codeThatThinks/autotank/Readme.md

# Autotank

A robotic tank designed to carry heavy objects both indoors and outdoors. Currently RC control, but will eventually be autonomous with bluetooth-enabled "follow me" capability.
