codeThatThinks/autotank/Solidworks/autotank.SLDASM

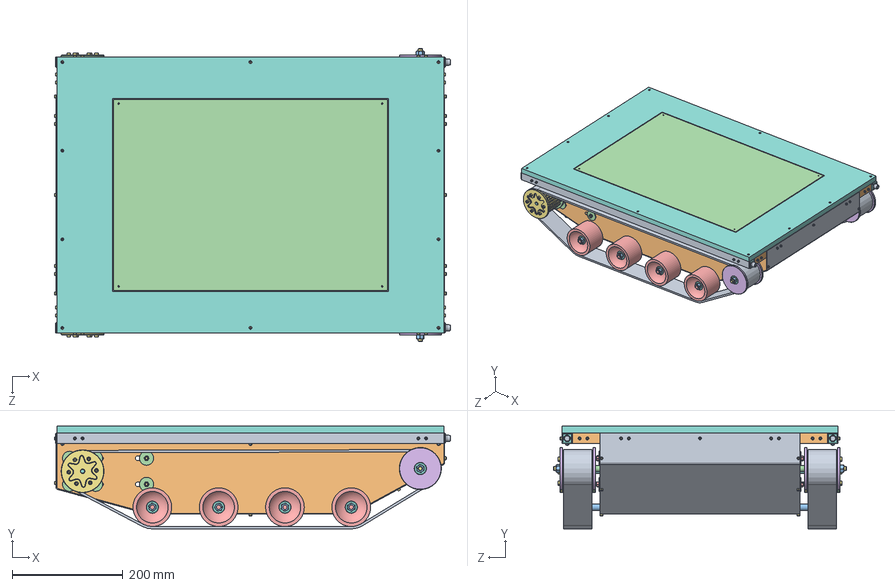
[picture p1: CAD file, 2020-02-22]
Solidworks/autotank.SLDASM
716.7 x 186.0 x 530.0 mm
chassis_bottom_plate
chassis_side_plate x 2
chassis_road_wheel_spacer x 8
chassis_idler_pulley_spacer x 2
chassis_road_wheel_axle x 4
chassis_road_wheel_support x 4
socket head cap screw_am x 80
deck_top
deck_tube_side x 2
deck_tube_ends x 2
deck_tube_inside x 2
deck_top_hatch
deck_tube_inside_support
deck_corner_bracket x 12
deck_tube_cap x 2
deck_tube_cap_front x 2
headlight x 2
socket countersunk head screw_am x 34
hex nut style 1_am x 65
self-clinching nut_pmm x 4
track_road_wheel x 8
track_idler_pulley x 2
track_drive_pulley x 2
bearing_608 x 22
track_belt^track x 2
track_idler_pulley_spacer x 2
track_shaft_collar x 2
track_drive_pulley_end_cap x 2
track_drive_pulley_threaded_insert x 12
motor_turnigy_d5035_125kv x 2
motor_adapter_nema23_44mm_countersunk x 2
shaft_8mm_keyed^motor x 2
motor_mounting_plate x 2
motor_tensioner_plate x 2
motor_tensioner_ball_bearing^motor x 2
flat washer type b wide_ai x 12
nut_m5_din934 x 12
motor_slot_spacer x 8
belt_tensioner_plate x 4
belt_tensioner_nut^belt_tensioner x 2
