codeThatThinks/autotank/Solidworks/belt_tensioner/belt_tensioner.SLDASM

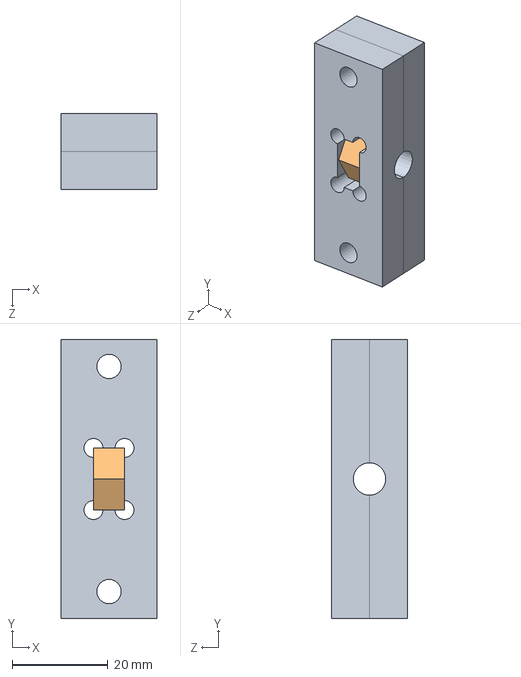
[picture p2: CAD file, 2020-02-22]
Solidworks/belt_tensioner/belt_tensioner.SLDASM
20.0 x 58.4 x 15.9 mm
belt_tensioner_plate x 2
belt_tensioner_nut^belt_tensioner
