codeThatThinks/autotank/Solidworks/deck/deck.SLDASM

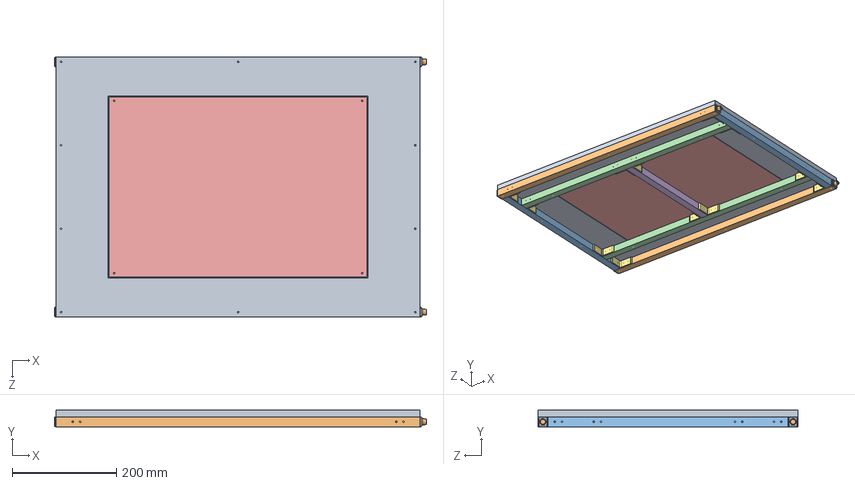
[picture p3: CAD file, 2020-02-22]
Solidworks/deck/deck.SLDASM
715.1 x 31.8 x 500.0 mm
deck_top
deck_tube_side x 2
deck_tube_ends x 2
deck_tube_inside x 2
deck_top_hatch
deck_tube_inside_support
deck_corner_bracket x 12
deck_tube_cap x 2
deck_tube_cap_front x 2
headlight x 2
