codeThatThinks/autotank/Solidworks/motor/motor.SLDASM

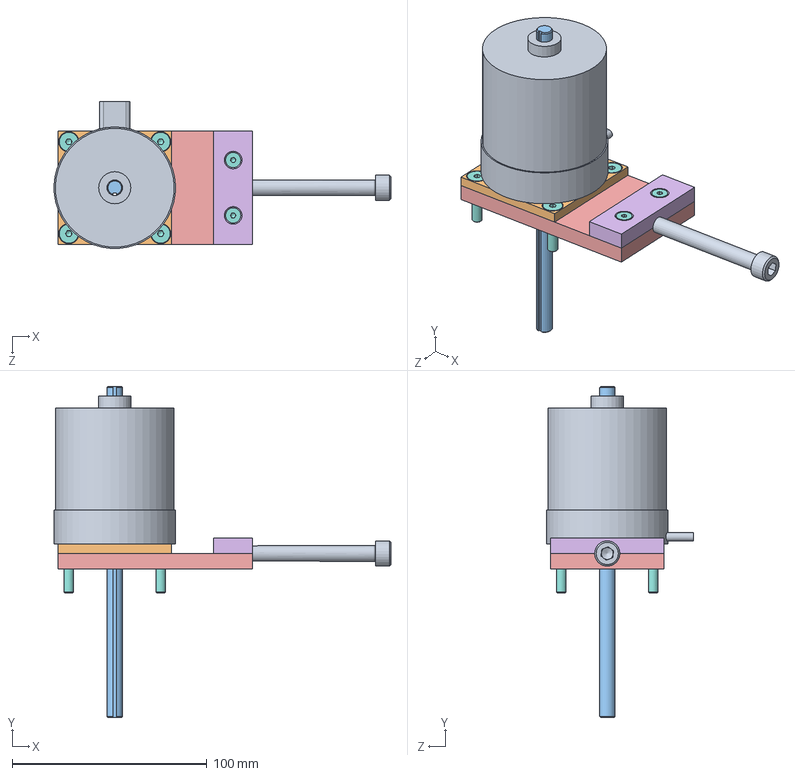
[picture p4: CAD file, 2020-02-22]
Solidworks/motor/motor.SLDASM
173.0 x 170.0 x 75.3 mm
motor_turnigy_d5035_125kv
motor_adapter_nema23_44mm_countersunk
shaft_8mm_keyed^motor
bearing_608
motor_mounting_plate
motor_tensioner_plate
motor_tensioner_ball_bearing^motor
socket countersunk head screw_am x 10
socket head cap screw_am
