codeThatThinks/autotank/Solidworks/track/track.SLDASM

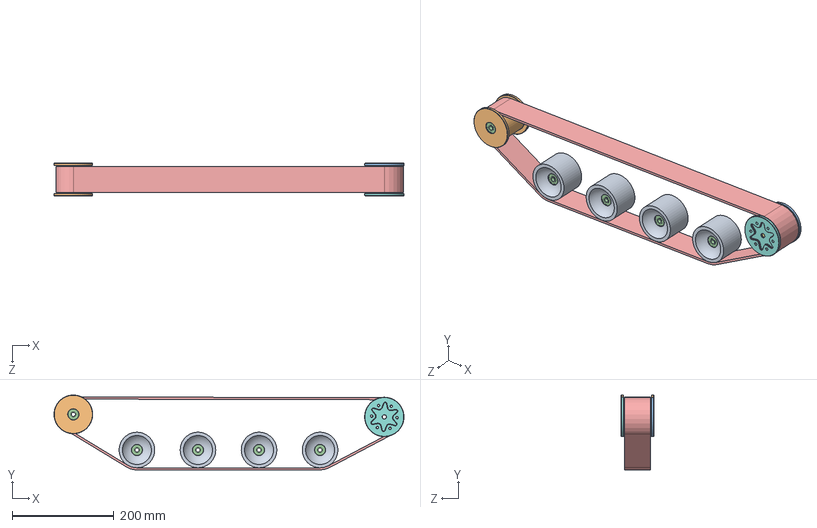
[picture p5: CAD file, 2020-02-22]
Solidworks/track/track.SLDASM
687.9 x 147.2 x 64.8 mm
track_road_wheel x 4
track_idler_pulley
track_drive_pulley
bearing_608 x 10
track_belt^track
track_idler_pulley_spacer
track_shaft_collar
track_drive_pulley_end_cap
