codeThatThinks/autotank/Solidworks/chassis/chassis.SLDASM

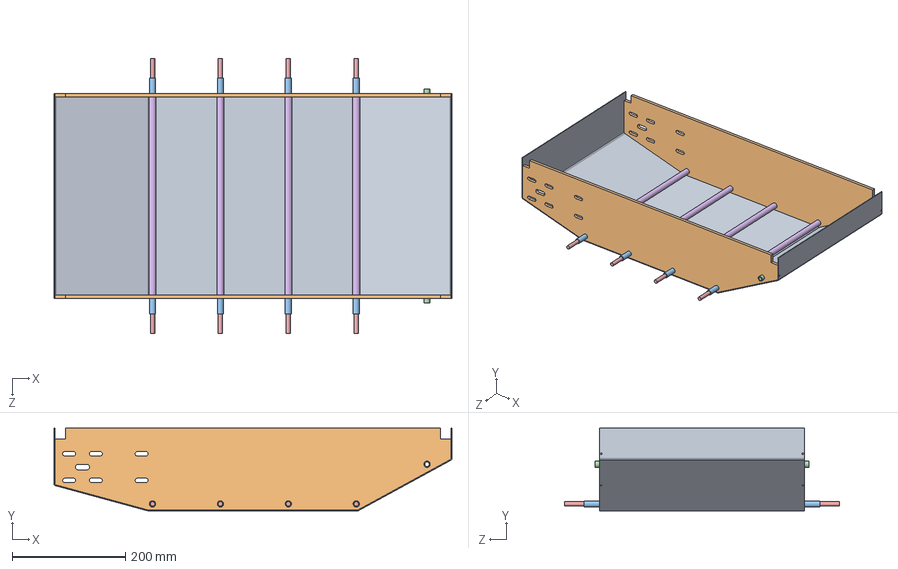
[picture p6: CAD file, 2020-02-22]
Solidworks/chassis/chassis.SLDASM
703.2 x 146.6 x 485.0 mm
chassis_bottom_plate
chassis_side_plate x 2
chassis_road_wheel_spacer x 8
chassis_idler_pulley_spacer x 2
chassis_road_wheel_axle x 4
chassis_road_wheel_support x 4
