codeThatThinks/autotank/Solidworks/track/track_right.SLDASM

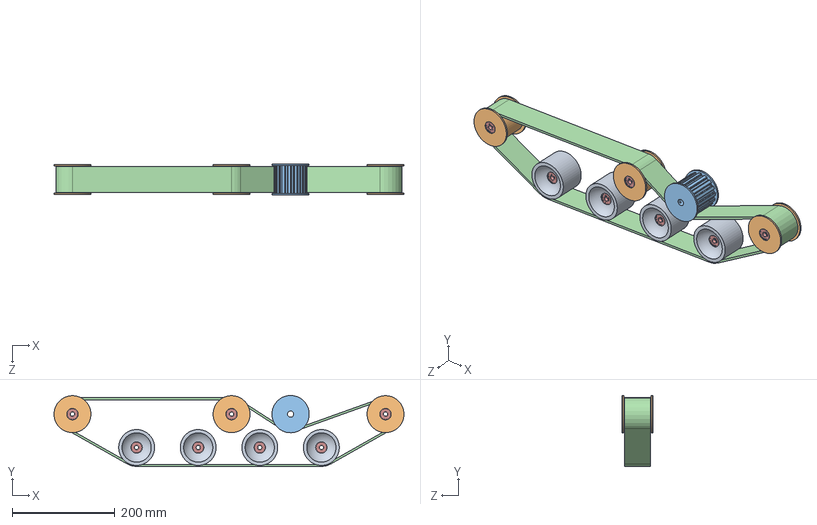
[picture p7: CAD file, 2019-06-30]
Solidworks/track/track_right.SLDASM
682.0 x 138.4 x 60.8 mm
track_road_wheel x 4
track_idler_pulley x 3
track_drive_pulley
track_belt^track_right
bearing_608 x 14
