codeThatThinks/autotank/Solidworks/track/track_left.SLDASM

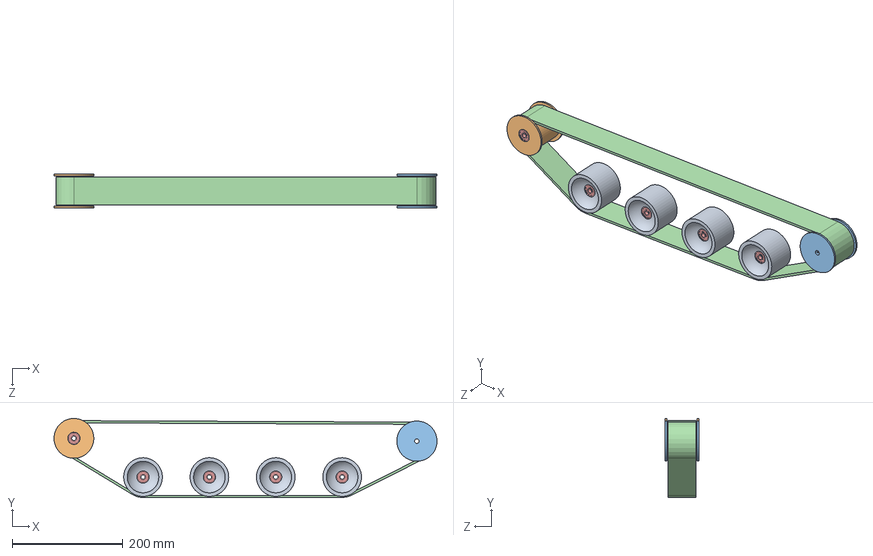
[picture p8: CAD file, 2019-06-30]
Solidworks/track/track_left.SLDASM
692.5 x 143.0 x 60.8 mm
track_road_wheel x 4
track_idler_pulley
track_drive_pulley
track_belt^track_left
bearing_608 x 10
