codeThatThinks/autotank/Solidworks/chassis/chassis_bottom_plate.sldprt

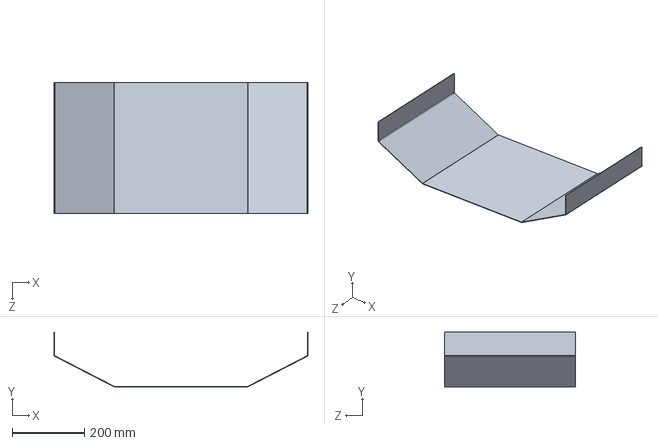
[picture p9: CAD file, 2020-02-22]
Solidworks/chassis/chassis_bottom_plate.sldprt
703.2 x 151.6 x 362.7 mm
