codeThatThinks/autotank/Solidworks/belt_tensioner/belt_tensioner_plate.SLDPRT

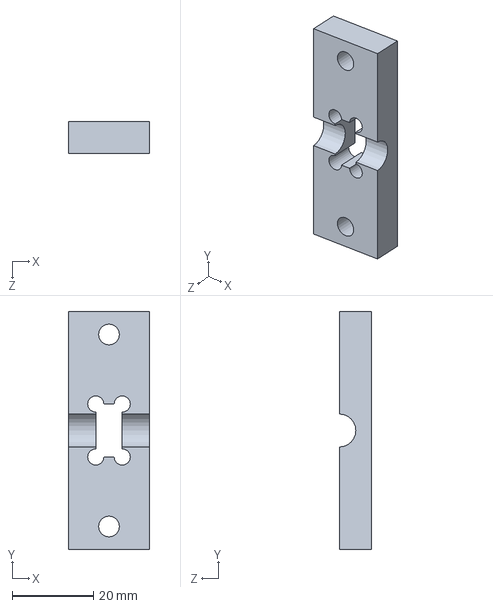
[picture p10: CAD file, 2020-02-22]
Solidworks/belt_tensioner/belt_tensioner_plate.SLDPRT
20.0 x 58.4 x 7.94 mm
