codeThatThinks/autotank/Solidworks/chassis/chassis_idler_pulley_spacer.SLDPRT

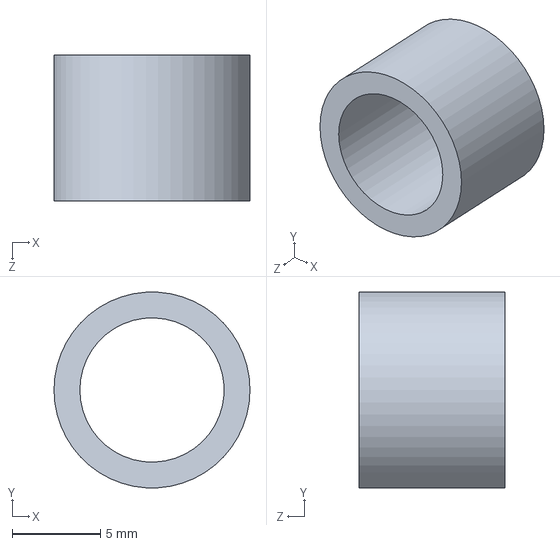
[picture p11: CAD file, 2020-02-22]
Solidworks/chassis/chassis_idler_pulley_spacer.SLDPRT
11.1 x 11.1 x 8.30 mm
