codeThatThinks/autotank/Solidworks/deck/deck_corner_bracket.SLDPRT

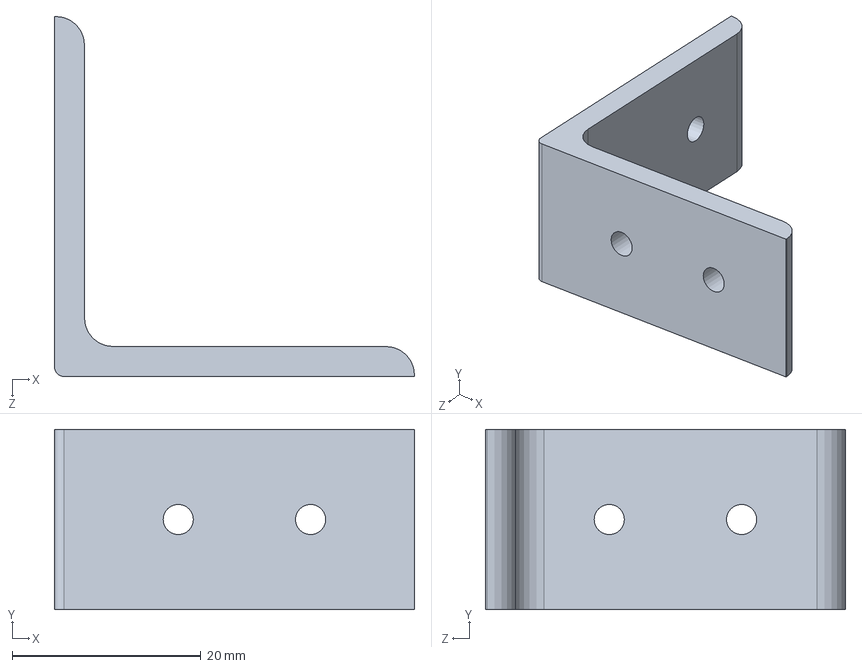
[picture p12: CAD file, 2020-02-22]
Solidworks/deck/deck_corner_bracket.SLDPRT
38.1 x 19.1 x 38.1 mm
