codeThatThinks/autotank/Solidworks/motor/motor_mounting_plate.sldprt

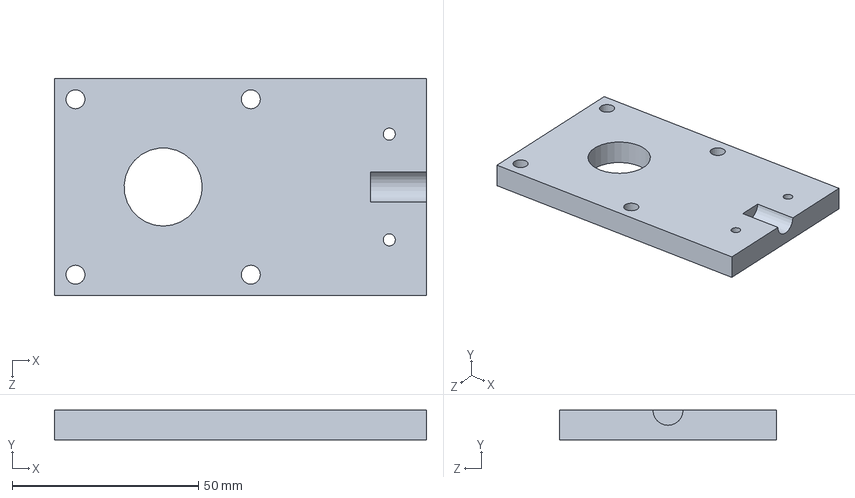
[picture p13: CAD file, 2020-02-22]
Solidworks/motor/motor_mounting_plate.sldprt
100.0 x 7.94 x 58.4 mm
