codeThatThinks/autotank/Solidworks/track/track_idler_pulley.SLDPRT

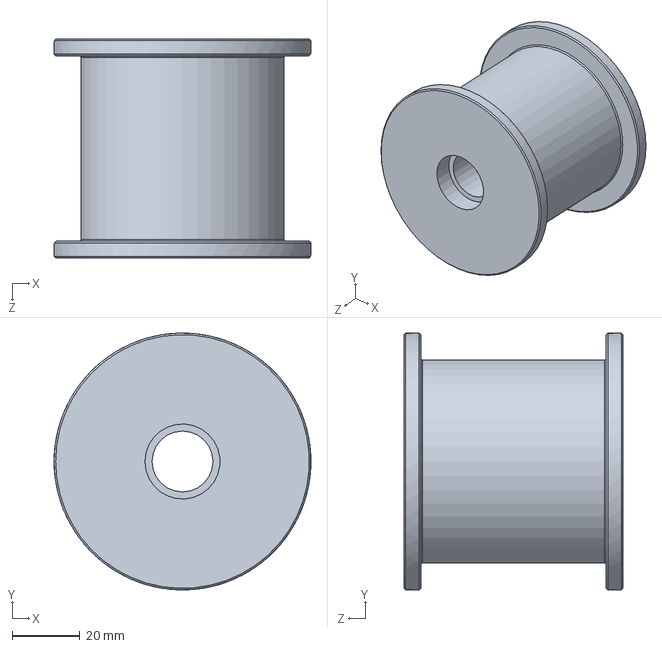
[picture p14: CAD file, 2020-02-22]
Solidworks/track/track_idler_pulley.SLDPRT
76.0 x 76.0 x 64.8 mm
