codeThatThinks/autotank/Solidworks/chassis/chassis_road_wheel_support.SLDPRT

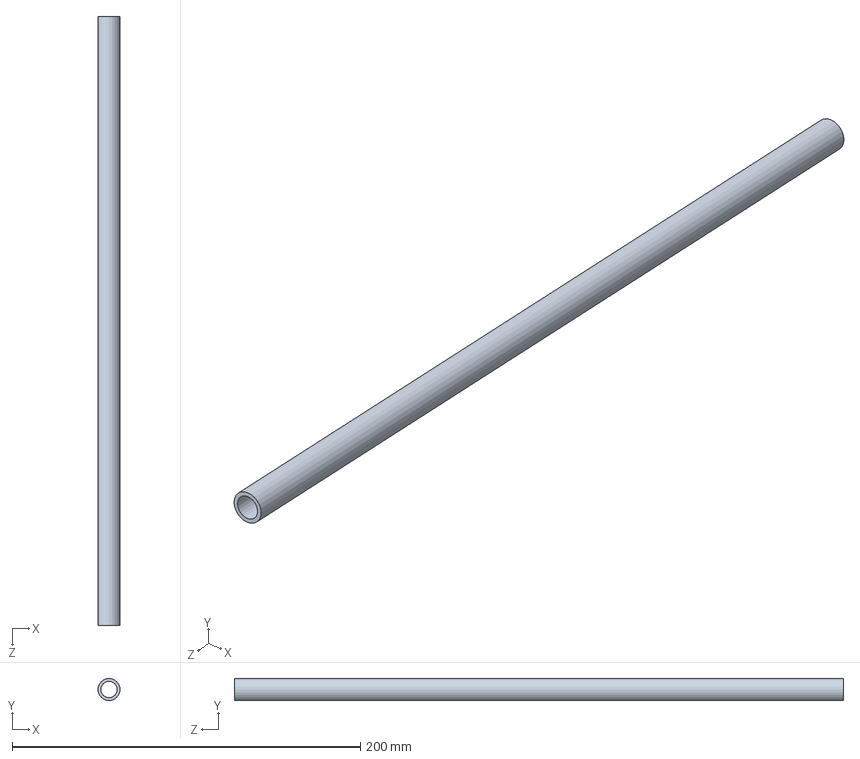
[picture p15: CAD file, 2020-02-22]
Solidworks/chassis/chassis_road_wheel_support.SLDPRT
12.7 x 12.7 x 350.0 mm
