codeThatThinks/autotank/Solidworks/deck/deck_tube_cap.SLDPRT

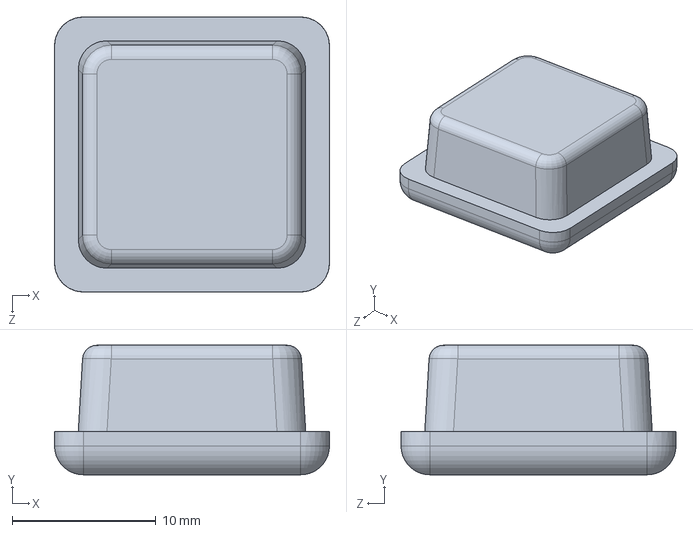
[picture p16: CAD file, 2020-02-22]
Solidworks/deck/deck_tube_cap.SLDPRT
19.1 x 9.00 x 19.1 mm
