codeThatThinks/autotank/Solidworks/motor/motor_tensioner_plate.sldprt

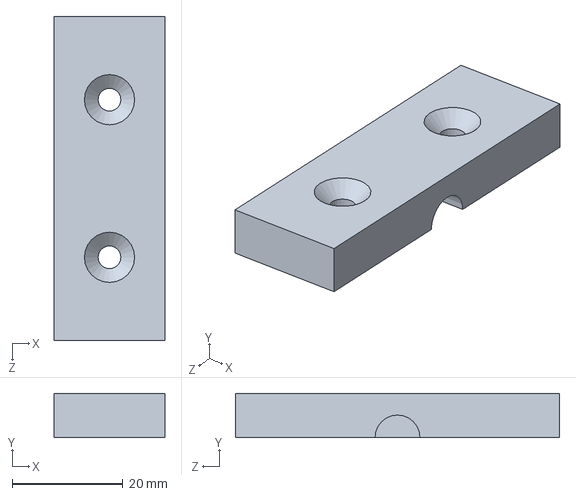
[picture p17: CAD file, 2020-02-22]
Solidworks/motor/motor_tensioner_plate.sldprt
20.0 x 7.94 x 58.4 mm
