codeThatThinks/autotank/Solidworks/track/track_drive_pulley_end_cap.SLDPRT

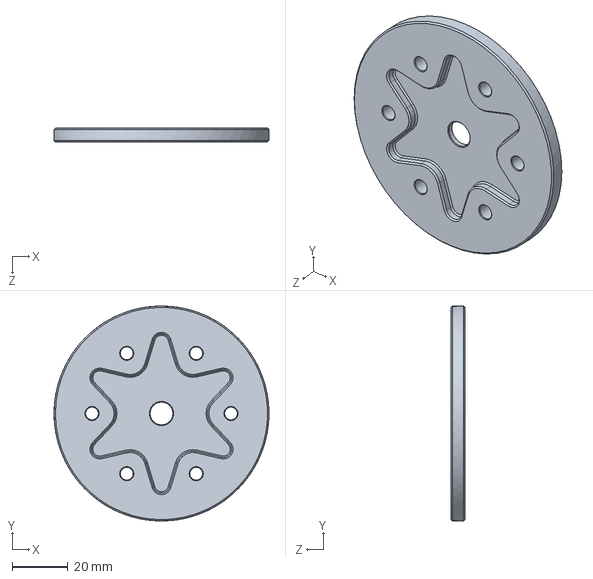
[picture p18: CAD file, 2020-02-22]
Solidworks/track/track_drive_pulley_end_cap.SLDPRT
77.3 x 77.3 x 5.00 mm
