codeThatThinks/autotank/Solidworks/chassis/chassis_road_wheel_spacer.SLDPRT

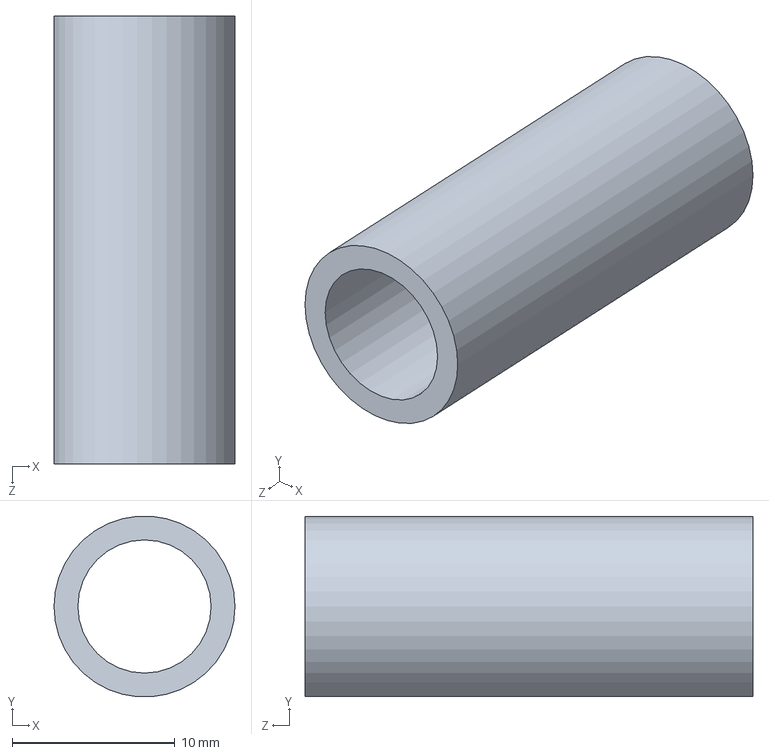
[picture p19: CAD file, 2020-02-22]
Solidworks/chassis/chassis_road_wheel_spacer.SLDPRT
11.1 x 11.1 x 27.5 mm
