codeThatThinks/autotank/Solidworks/deck/deck_top.SLDPRT

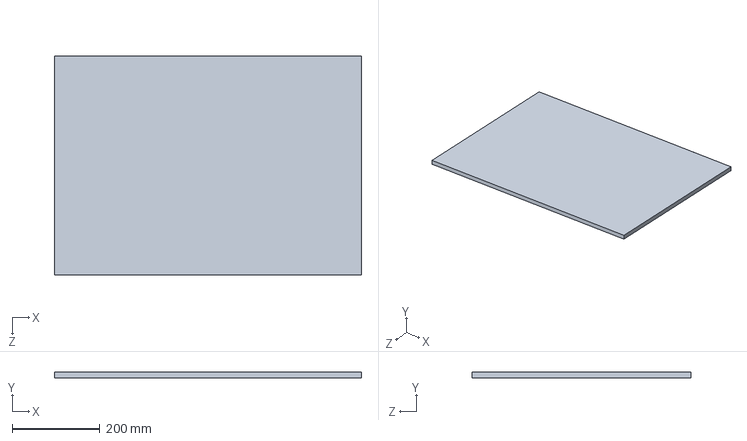
[picture p20: CAD file, 2020-02-22]
Solidworks/deck/deck_top.SLDPRT
700.0 x 12.7 x 500.0 mm
