codeThatThinks/autotank/Solidworks/motor/motor_slot_spacer.SLDPRT

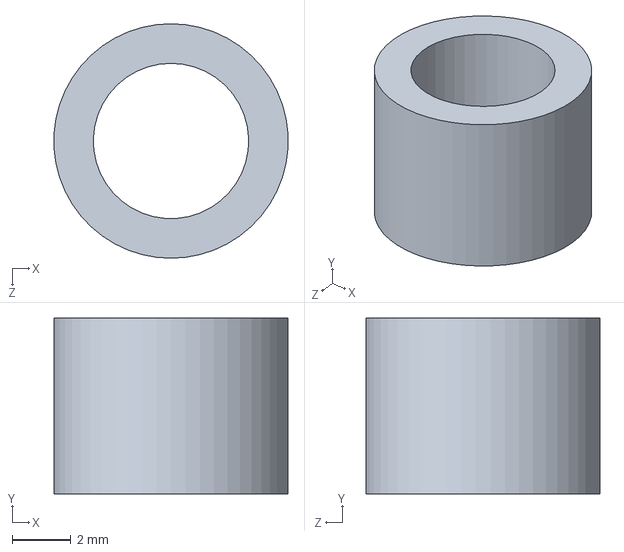
[picture p21: CAD file, 2020-02-22]
Solidworks/motor/motor_slot_spacer.SLDPRT
7.98 x 6.00 x 8.00 mm
