codeThatThinks/autotank/Solidworks/track/track_shaft_collar.SLDPRT

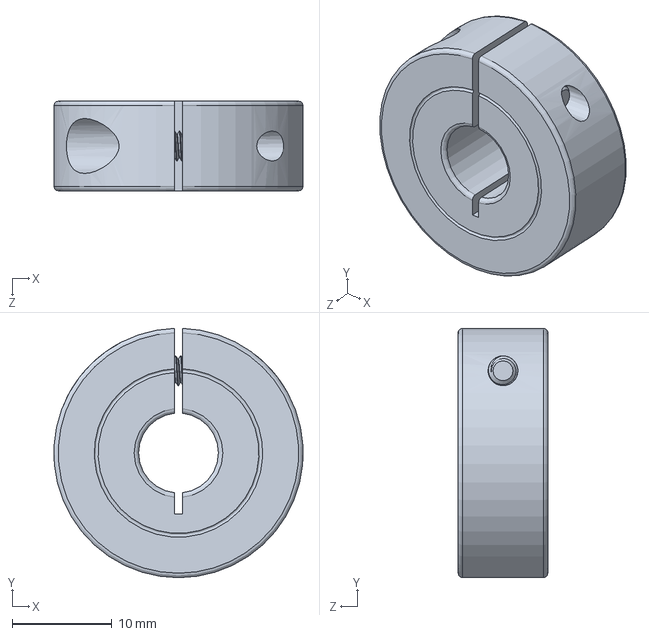
[picture p22: CAD file, 2020-02-22]
Solidworks/track/track_shaft_collar.SLDPRT
25.0 x 25.0 x 9.00 mm
