codeThatThinks/autotank/Solidworks/deck/headlight.SLDPRT

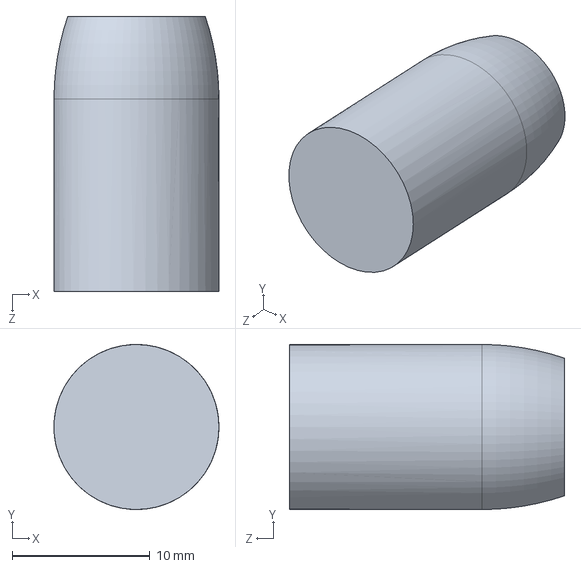
[picture p23: CAD file, 2020-02-22]
Solidworks/deck/headlight.SLDPRT
12.0 x 12.0 x 20.0 mm
