codeThatThinks/autotank/Solidworks/track/track_road_wheel.SLDPRT

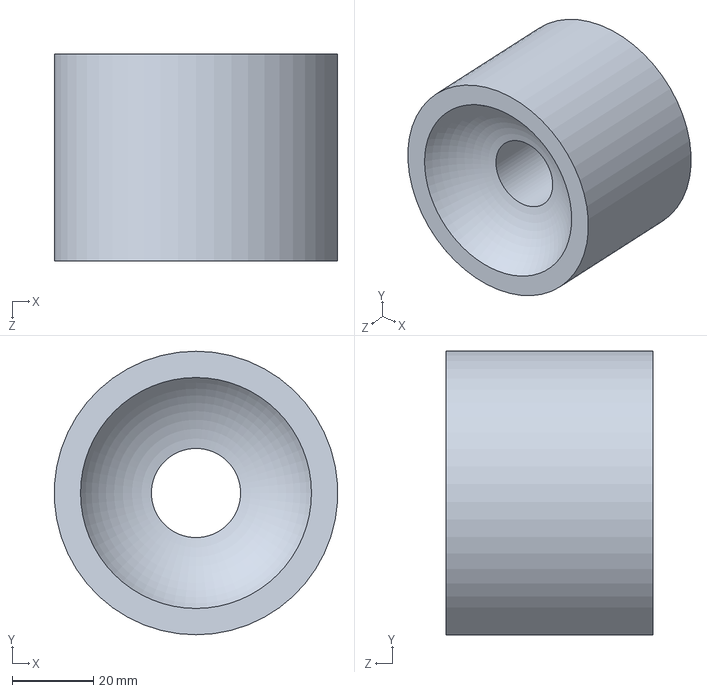
[picture p24: CAD file, 2020-02-22]
Solidworks/track/track_road_wheel.SLDPRT
69.9 x 70.0 x 51.0 mm
