codeThatThinks/autotank/Solidworks/chassis/chassis_road_wheel_axle.SLDPRT

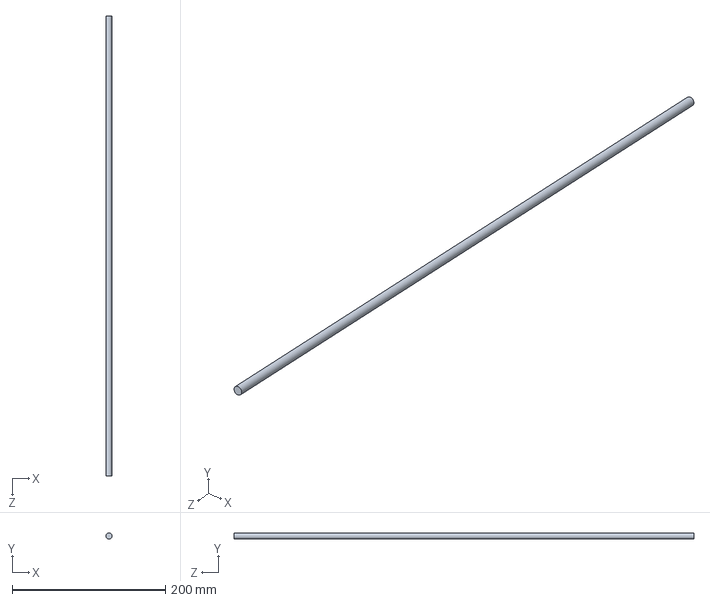
[picture p25: CAD file, 2020-02-22]
Solidworks/chassis/chassis_road_wheel_axle.SLDPRT
8.00 x 8.00 x 600.0 mm
