codeThatThinks/autotank/Solidworks/deck/deck_tube_inside_support.sldprt

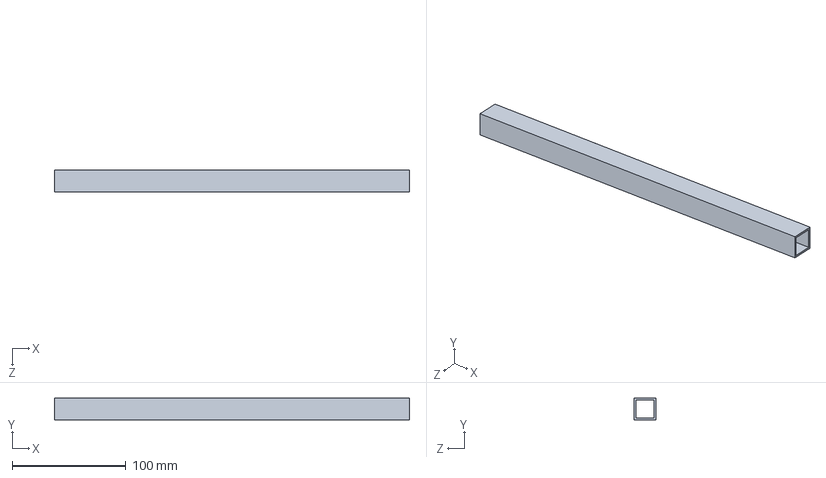
[picture p26: CAD file, 2020-02-22]
Solidworks/deck/deck_tube_inside_support.sldprt
311.9 x 19.0 x 19.1 mm
