codeThatThinks/autotank/Solidworks/track/track_drive_pulley_threaded_insert.SLDPRT

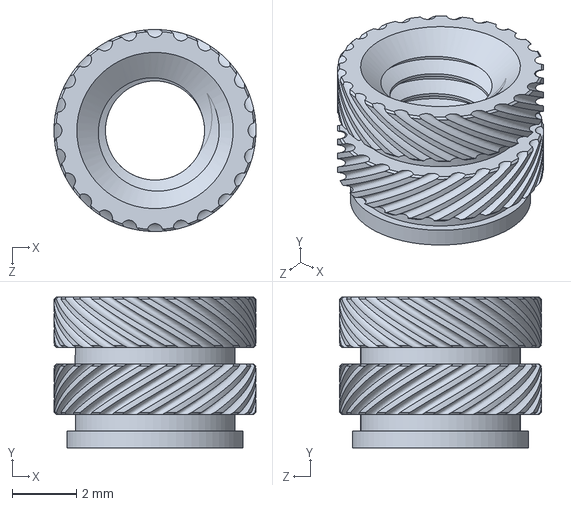
[picture p27: CAD file, 2020-02-22]
Solidworks/track/track_drive_pulley_threaded_insert.SLDPRT
6.30 x 4.70 x 6.30 mm
