codeThatThinks/autotank/Solidworks/chassis/chassis_side_plate.SLDPRT

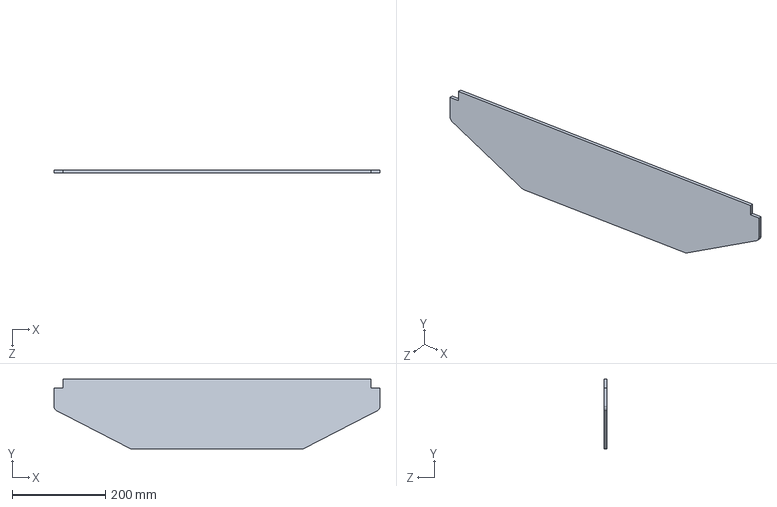
[picture p28: CAD file, 2020-02-22]
Solidworks/chassis/chassis_side_plate.SLDPRT
700.0 x 150.0 x 6.35 mm
