codeThatThinks/autotank/Solidworks/deck/deck_tube_side.sldprt

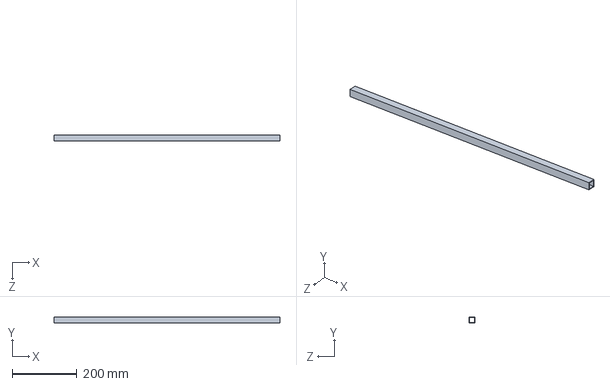
[picture p29: CAD file, 2020-02-22]
Solidworks/deck/deck_tube_side.sldprt
700.0 x 19.0 x 19.1 mm
