codeThatThinks/autotank/Solidworks/track/track_drive_pulley.SLDPRT

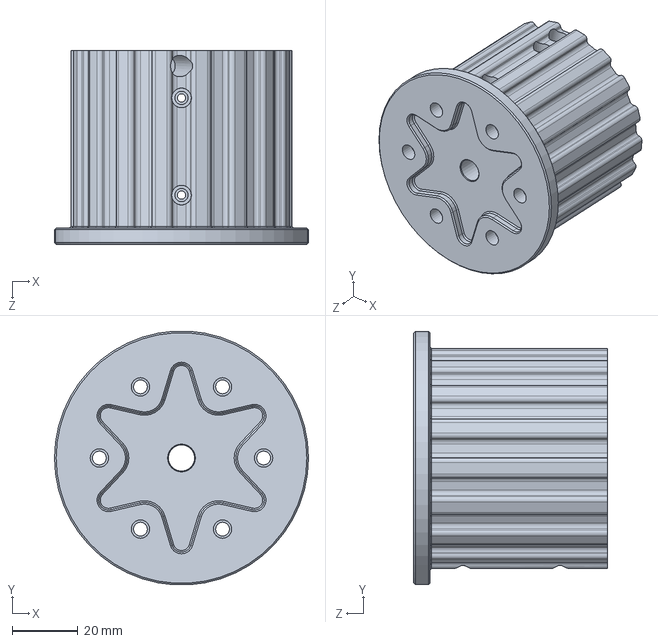
[picture p30: CAD file, 2020-02-22]
Solidworks/track/track_drive_pulley.SLDPRT
77.3 x 77.2 x 59.0 mm
