codeThatThinks/autotank/Solidworks/deck/deck_tube_cap_front.SLDPRT

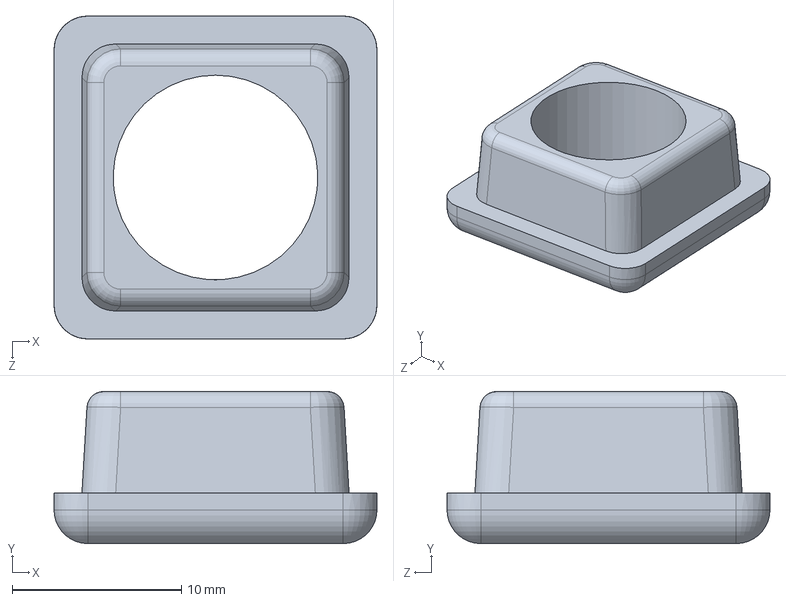
[picture p31: CAD file, 2020-02-22]
Solidworks/deck/deck_tube_cap_front.SLDPRT
19.1 x 9.00 x 19.1 mm
