codeThatThinks/autotank/Solidworks/track/track_idler_pulley_spacer.sldprt

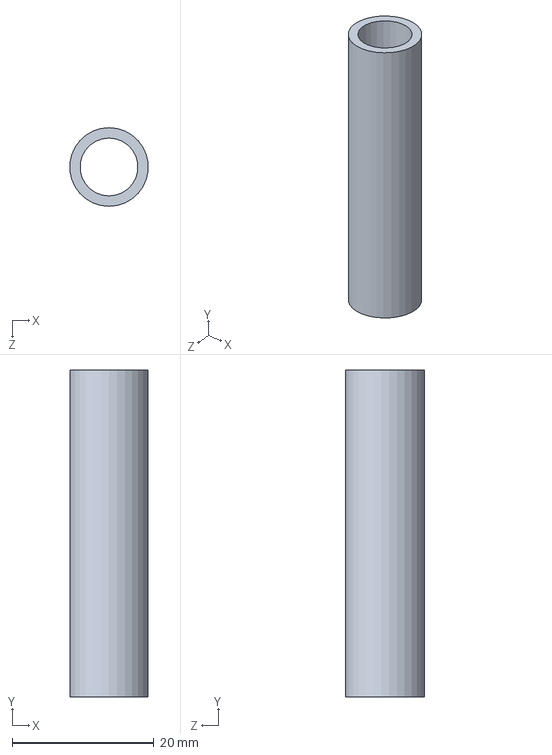
[picture p32: CAD file, 2020-02-22]
Solidworks/track/track_idler_pulley_spacer.sldprt
11.1 x 46.2 x 11.1 mm
