codeThatThinks/autotank/Solidworks/deck/deck_tube_ends.sldprt

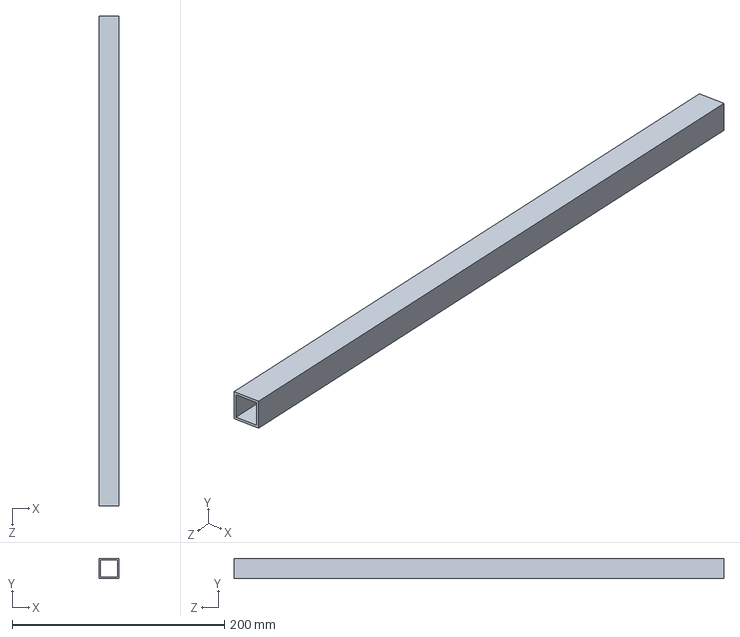
[picture p33: CAD file, 2020-02-22]
Solidworks/deck/deck_tube_ends.sldprt
19.1 x 19.0 x 461.9 mm
