codeThatThinks/autotank/Solidworks/deck/deck_tube_inside.sldprt

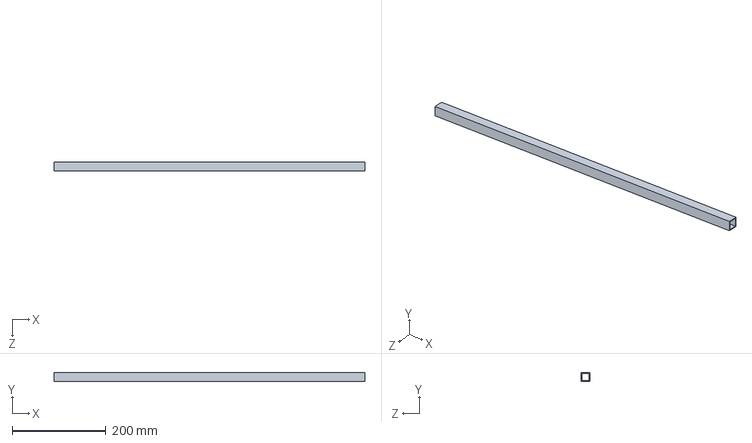
[picture p34: CAD file, 2020-02-22]
Solidworks/deck/deck_tube_inside.sldprt
661.9 x 19.0 x 19.1 mm
