codeThatThinks/autotank/Solidworks/track/track_timing_pulley.SLDPRT

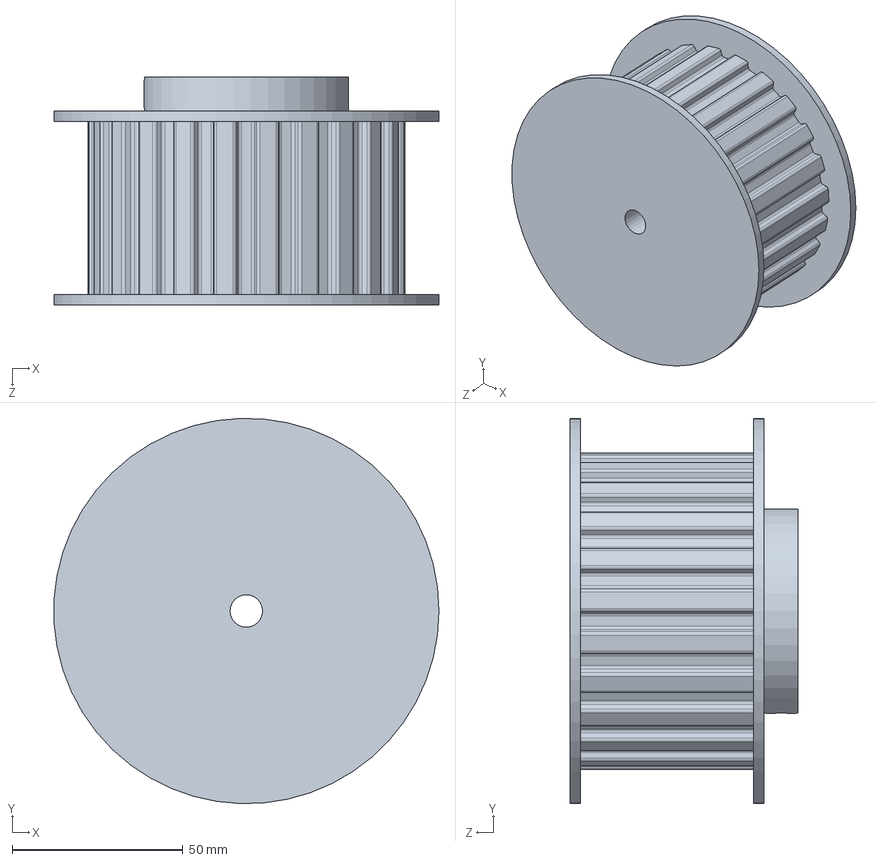
[picture p35: CAD file, 2019-06-30]
Solidworks/track/track_timing_pulley.SLDPRT
112.9 x 112.9 x 66.8 mm
