codeThatThinks/autotank/Solidworks/deck/deck_top_hatch.SLDPRT

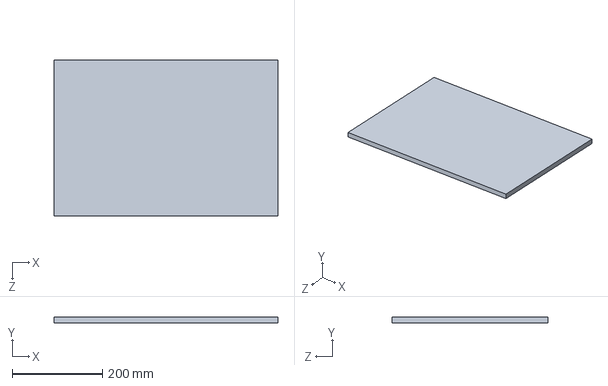
[picture p36: CAD file, 2020-02-22]
Solidworks/deck/deck_top_hatch.SLDPRT
496.0 x 12.7 x 346.0 mm
