codeThatThinks/autotank/(list of files, cad)

Other CAD files:
Solidworks/belt_tensioner/belt_tensioner_plate.SLDDRW
Solidworks/chassis/chassis_bottom_plate.SLDDRW
Solidworks/chassis/chassis_idler_pulley_spacer.SLDDRW
Solidworks/chassis/chassis_road_wheel_spacer.SLDDRW
Solidworks/chassis/chassis_side_plate.SLDDRW
Solidworks/deck/deck.SLDDRW
Solidworks/deck/deck_corner_bracket.SLDDRW
Solidworks/motor/motor.SLDDRW
Solidworks/motor/motor_adapter_nema23_44mm_countersunk.SLDDRW
Solidworks/motor/motor_mounting.SLDDRW
Solidworks/motor/motor_mounting_plate.SLDDRW
Solidworks/motor/motor_tensioner_plate.SLDDRW
Solidworks/track/track.SLDDRW
Solidworks/track/track_drive_pulley.SLDDRW
Solidworks/track/track_drive_pulley_end_cap.SLDDRW
Solidworks/track/track_idler_pulley.SLDDRW
Solidworks/track/track_idler_pulley_spacer.SLDDRW
