codeThatThinks/autotank/(threads)

Thread 1 (2023-10-28):

Nice tank! - Open hardware canbus BLDC

samuk, 2023-10-28:
Hi I like your tank. I wondered if you were familar with this open hardware Canbus enabled CM4 carrier:
https://github.com/Twisted-Fields/acorn-robot-electronics

And this Canbus BLDC driver: https://github.com/Twisted-Fields/rp2040-motor-controller

They might work well in the tank?
