codeThatThinks/autotank/PDF/Deck Assembly.PDF

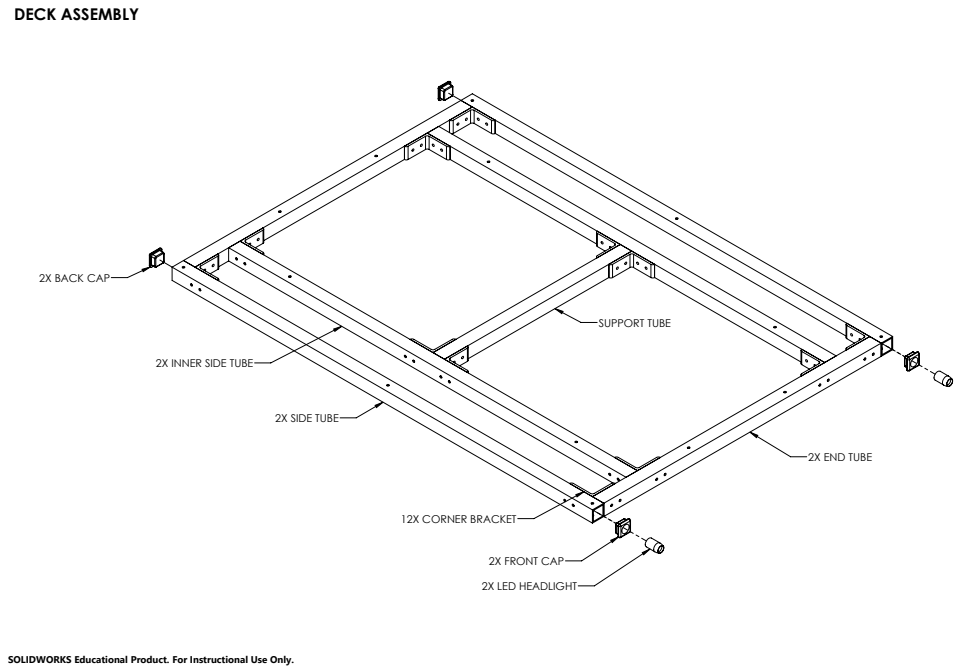
[picture p37: page 1]
2X LED HEADLIGHT; 2X FRONT CAP; 2X BACK CAP; 2X SIDE TUBE; 12X CORNER BRACKET; SUPPORT TUBE; 2X END TUBE; DECK ASSEMBLY

2X INNER SIDE TUBE

SOLIDWORKS Educational Product. For Instructional Use Only.
