codeThatThinks/autotank/PDF/Motor Assembly.PDF

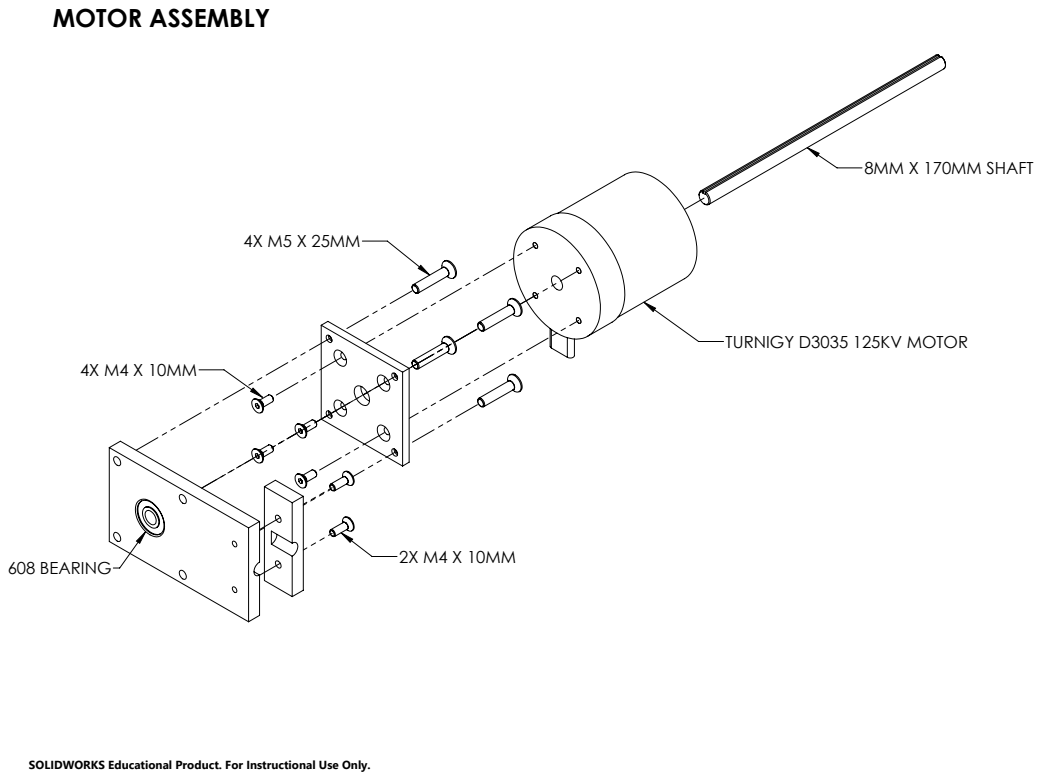
[picture p38: page 1]
TURNIGY D3035 125KV MOTOR; 8MM X 170MM SHAFT; 2X M4 X 10MM 608 BEARING; MOTOR ASSEMBLY

SOLIDWORKS Educational Product. For Instructional Use Only.
