codeThatThinks/autotank/PDF/Track Assembly.PDF

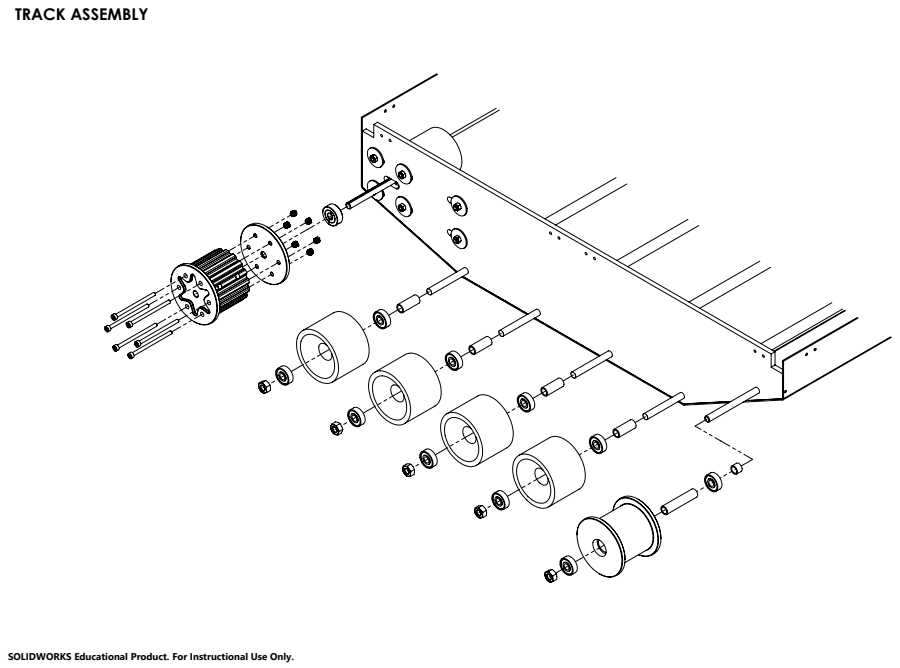
[picture p39: page 1]
TRACK ASSEMBLY

SOLIDWORKS Educational Product. For Instructional Use Only.
