codeThatThinks/autotank/PDF/Chassis Bottom Plate.PDF

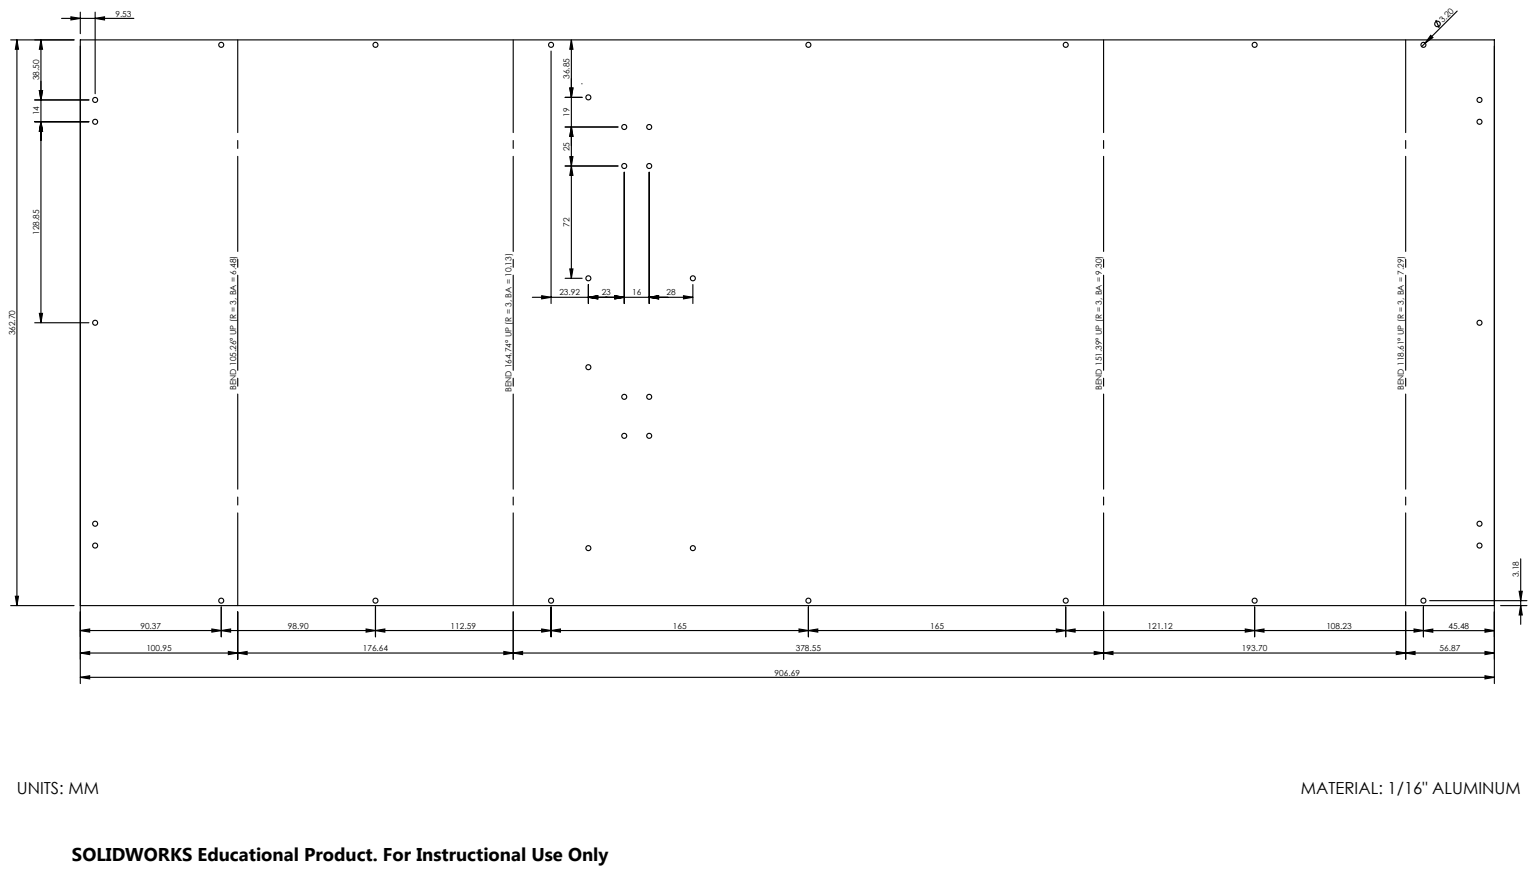
[picture p40: page 1]
UNITS: MM; MATERIAL: 1/16" ALUMINUM

BEND 105.26° UP (R = 3, BA = 6.48)

BEND 164.74° UP (R = 3, BA = 10.13)

BEND 151.39° UP (R = 3, BA = 9.30)

BEND 118.61° UP (R = 3, BA = 7.29)

SOLIDWORKS Educational Product. For Instructional Use Only
