codeThatThinks/autotank/PDF/Chassis Side Plate.PDF

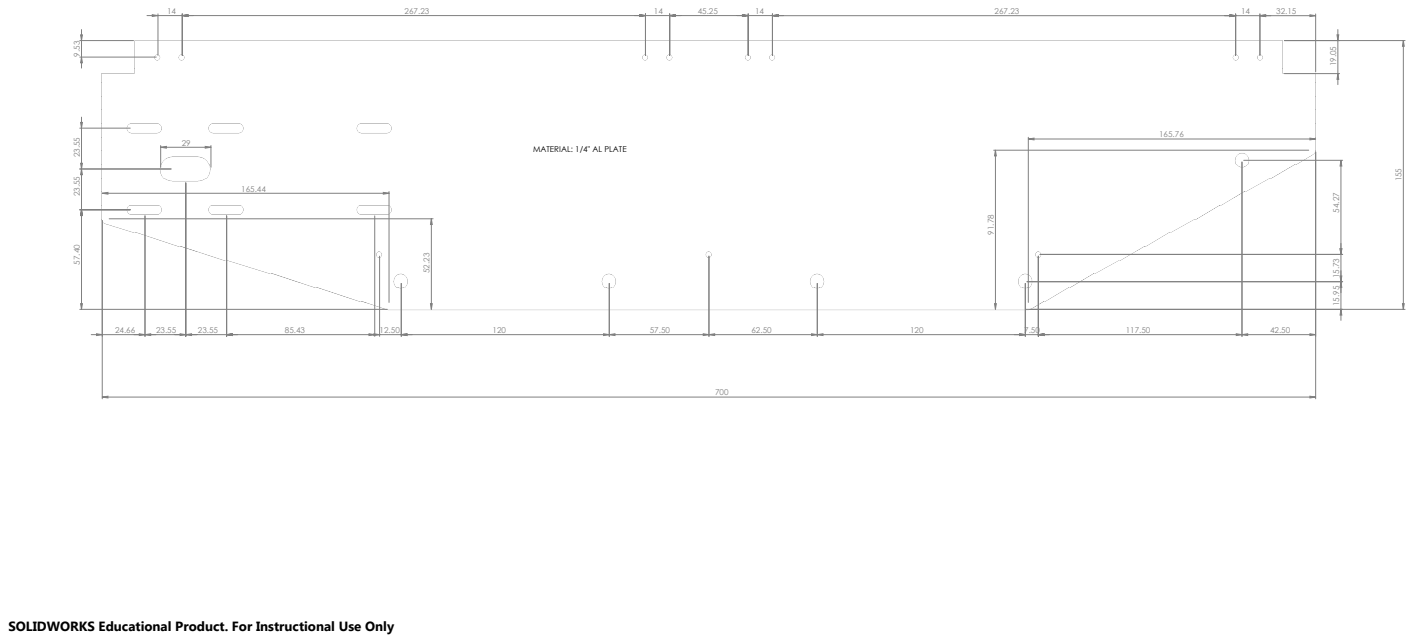
[picture p41: page 1]

MATERIAL: 1/4" AL PLATE

SOLIDWORKS Educational Product. For Instructional Use Only
