codeThatThinks/autotank/PDF/Motor Mounting.PDF

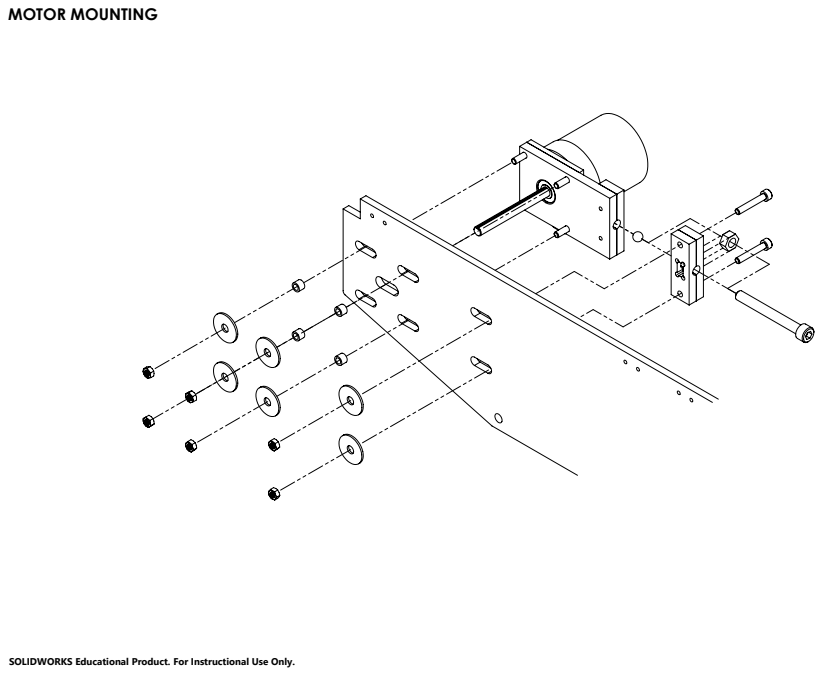
[picture p42: page 1]
MOTOR MOUNTING

SOLIDWORKS Educational Product. For Instructional Use Only.
