codeThatThinks/autotank/PDF/NEMA 23 Motor Adapter Plate.PDF

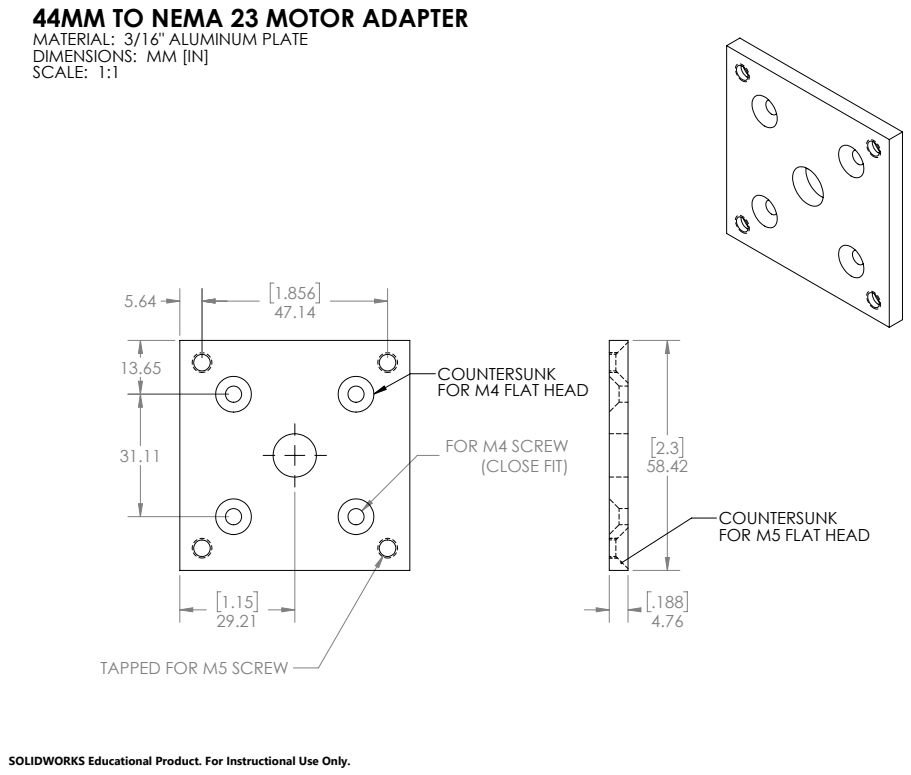
[picture p43: page 1]
FOR M4 SCREW (CLOSE FIT)

44MM TO NEMA 23 MOTOR ADAPTER
MATERIAL: 3/16" ALUMINUM PLATE
DIMENSIONS: MM [IN]
SCALE: 1:1

COUNTERSUNK
FOR M4 FLAT HEAD

FOR M5 FLAT HEAD

TAPPED FOR M5 SCREW

SOLIDWORKS Educational Product. For Instructional Use Only.
