codeThatThinks/autotank/PDF/Deck Corner Bracket.PDF

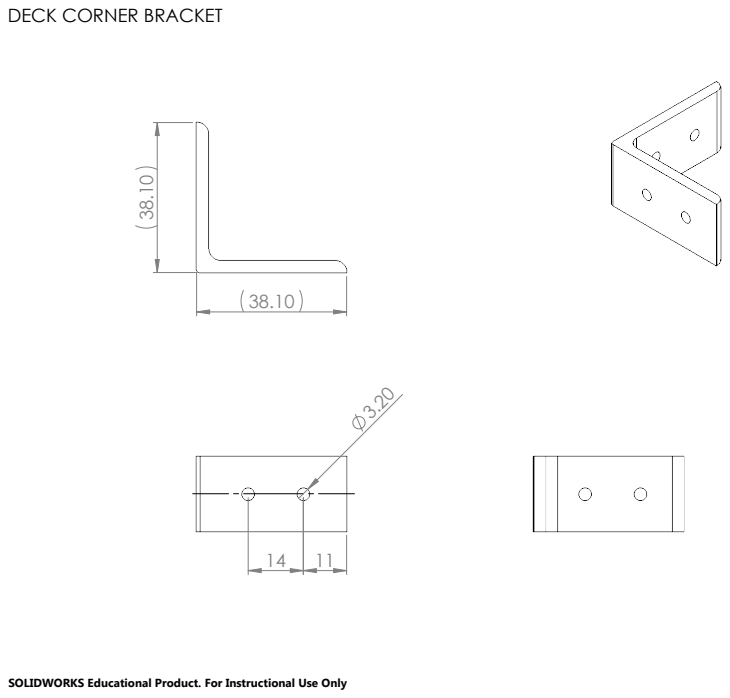
[picture p44: page 1]

DECK CORNER BRACKET

SOLIDWORKS Educational Product. For Instructional Use Only
