codeThatThinks/autotank/PDF/Drive Pulley End Cap.PDF

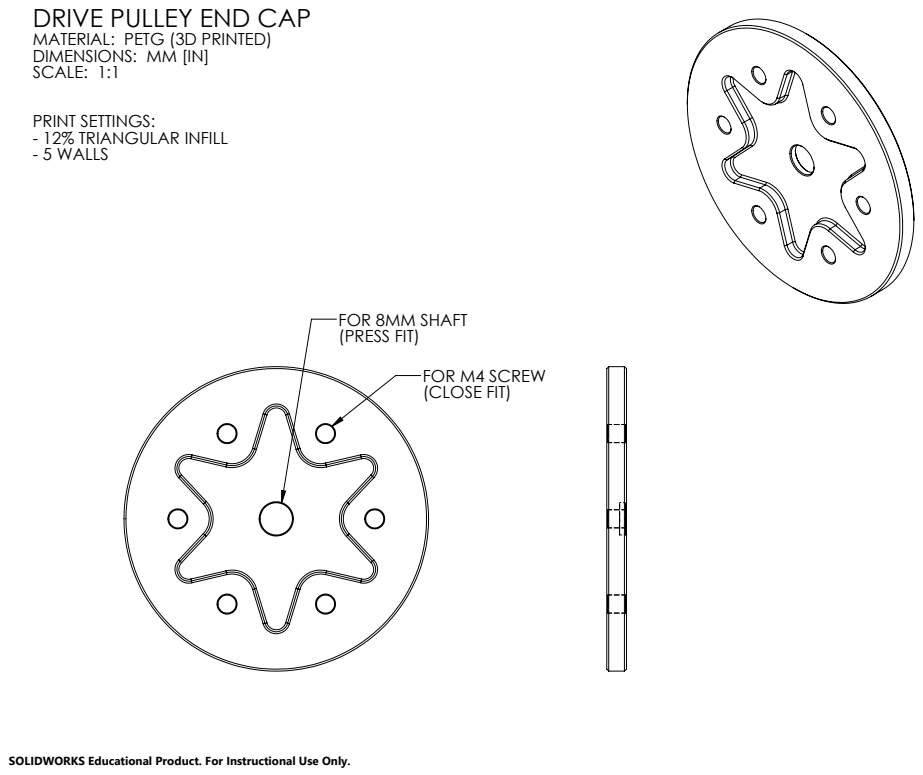
[picture p45: page 1]
FOR M4 SCREW (CLOSE FIT); FOR 8MM SHAFT (PRESS FIT); PRINT SETTINGS: - 12% TRIANGULAR INFILL - 5 WALLS

DRIVE PULLEY END CAP
MATERIAL: PETG (3D PRINTED)
DIMENSIONS: MM [IN]
SCALE: 1:1

SOLIDWORKS Educational Product. For Instructional Use Only.
