codeThatThinks/autotank/PDF/Drive Pulley.PDF

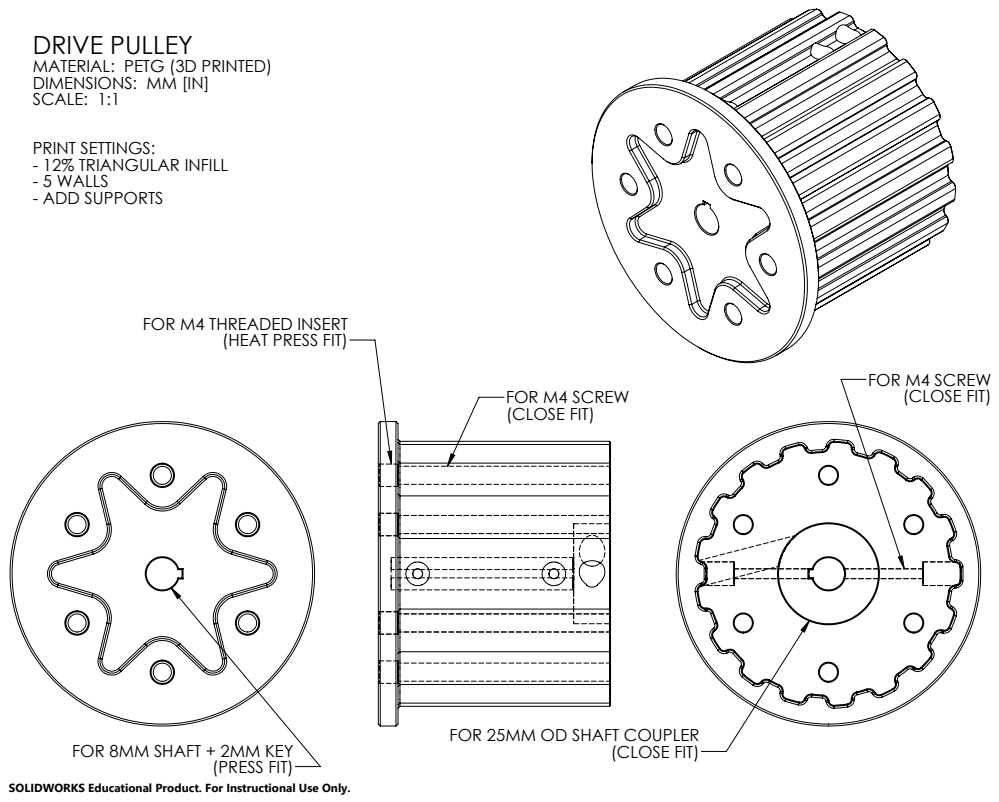
[picture p46: page 1]
(PRESS FIT); FOR M4 SCREW (CLOSE FIT); (CLOSE FIT); PRINT SETTINGS: - 12% TRIANGULAR INFILL - 5 WALLS - ADD SUPPORTS

DRIVE PULLEY
MATERIAL: PETG (3D PRINTED)
DIMENSIONS: MM [IN]
SCALE: 1:1

FOR M4 THREADED INSERT

(HEAT PRESS FIT)

FOR 25MM OD SHAFT COUPLER

FOR 8MM SHAFT + 2MM KEY

SOLIDWORKS Educational Product. For Instructional Use Only.
