codeThatThinks/autotank/PDF/Idler Pulley Shaft Spacer.PDF

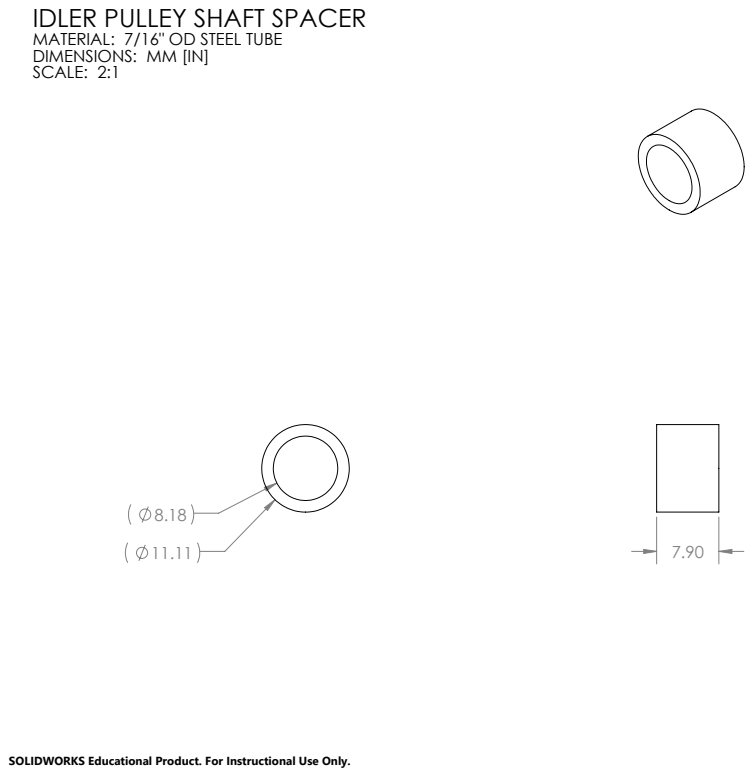
[picture p47: page 1]

IDLER PULLEY SHAFT SPACER
MATERIAL: 7/16" OD STEEL TUBE
DIMENSIONS: MM [IN]
SCALE: 2:1

SOLIDWORKS Educational Product. For Instructional Use Only.
