codeThatThinks/autotank/PDF/Idler Pulley.PDF

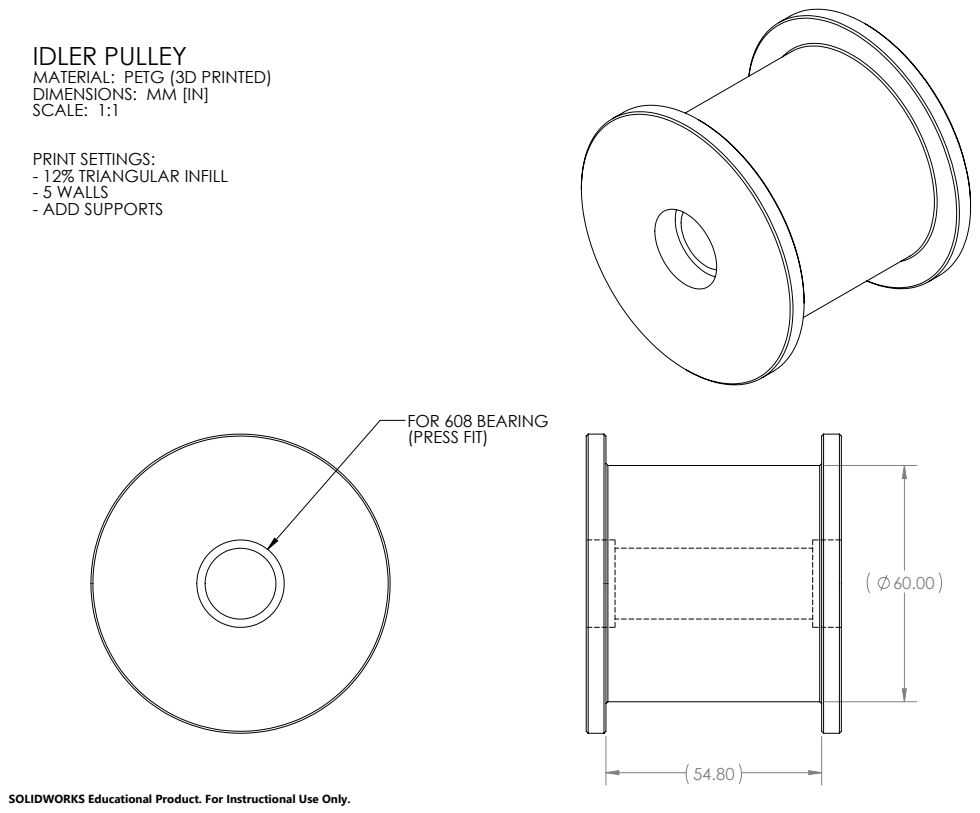
[picture p48: page 1]
FOR 608 BEARING (PRESS FIT); PRINT SETTINGS: - 12% TRIANGULAR INFILL - 5 WALLS - ADD SUPPORTS

IDLER PULLEY
MATERIAL: PETG (3D PRINTED)
DIMENSIONS: MM [IN]
SCALE: 1:1

SOLIDWORKS Educational Product. For Instructional Use Only.
