codeThatThinks/autotank/PDF/Belt Tensioner Plate.PDF

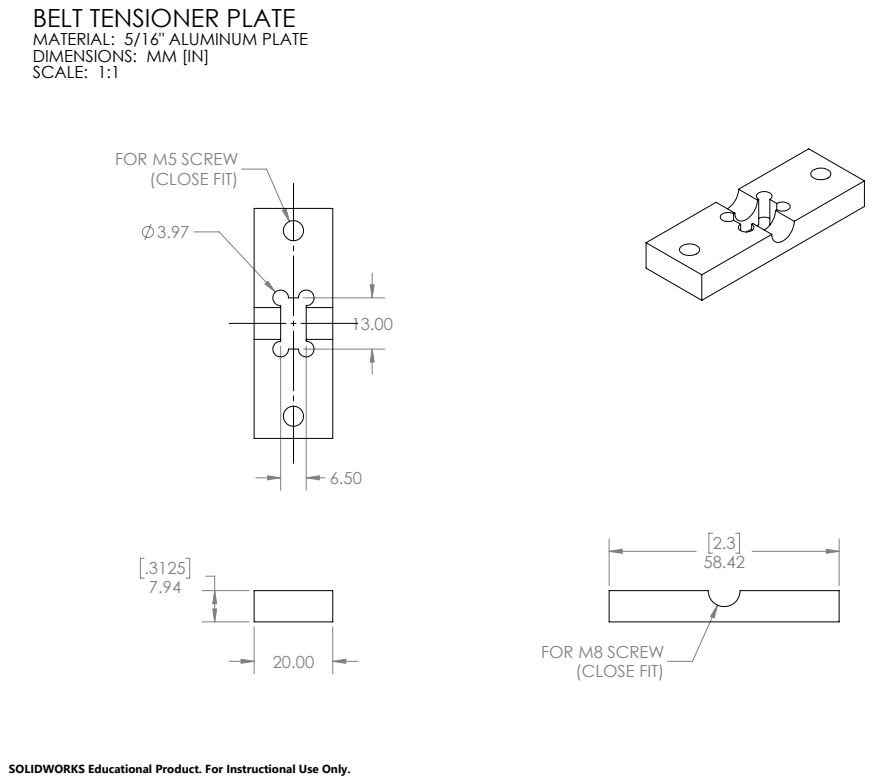
[picture p49: page 1]
FOR M5 SCREW (CLOSE FIT); FOR M8 SCREW (CLOSE FIT)

BELT TENSIONER PLATE
MATERIAL: 5/16" ALUMINUM PLATE
DIMENSIONS: MM [IN]
SCALE: 1:1

SOLIDWORKS Educational Product. For Instructional Use Only.
