codeThatThinks/autotank/PDF/Motor Mounting Plate.PDF

## MOTOR MOUNTING PLATE

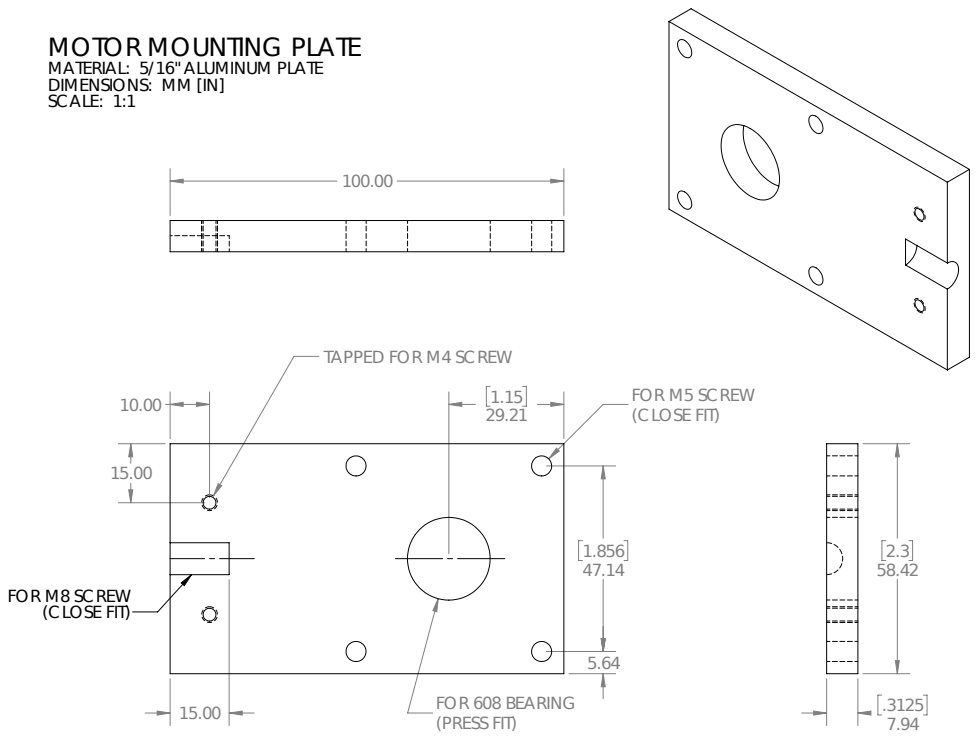
[picture p50: page 1]
FOR M5 SCREW (CLOSE FIT); FOR 608 BEARING (PRESS FIT); FOR M8 SCREW (CLOSE FIT)

MATERIAL: 5/16" ALUMINUM PLATE
DIMENSIONS: MM [IN]
SCALE: 1:1

TAPPED FOR M4 SCREW
