codeThatThinks/autotank/PDF/Motor Tensioner Plate.PDF

## MOTOR TENSIONER PLATE

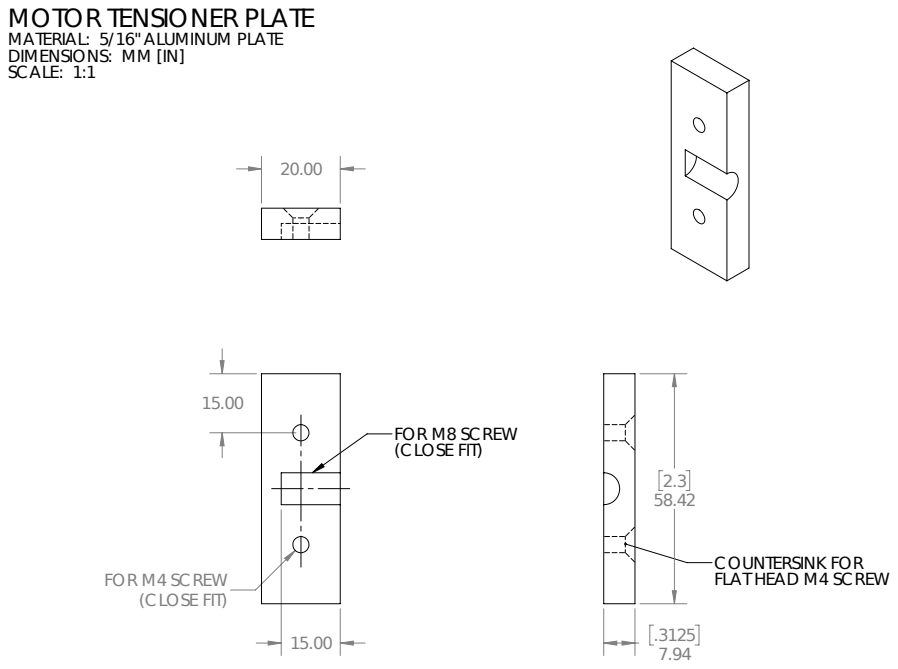
[picture p51: page 1]
FOR M4 SCREW (CLOSE FIT); FOR M8 SCREW (CLOSE FIT)

MATERIAL: 5/16" ALUMINUM PLATE
DIMENSIONS: MM [IN]
SCALE: 1:1

COUNTERSINK FOR
FLAT HEAD M4 SCREW
