codeThatThinks/autotank/(commit log)

2019-06-30 Switch to Turnigy D5035 125kv motor direct drive
    [Autotank.SLDASM, Belt1.SLDPRT, Belt2.SLDPRT, belt_tensioner.SLDASM, belt_tensioner_plate.SLDPRT, chassis.SLDASM, chassis_bottom_brace.SLDPRT, chassis_bottom_plate.sldprt]
2019-07-01 Add motor mounting hardware, shorten tensioner jacking bolt
    [Autotank.SLDASM, belt_tensioner.SLDASM, belt_tensioner_plate.SLDPRT, motor.SLDASM, motor_mounting_plate.sldprt, motor_slot_spacer.SLDPRT, motor_tensioner_plate.sldprt]
2019-07-01 Add drawings for motor assembly, fix some dimensions
    [Autotank.SLDASM, motor.SLDASM, motor.SLDDRW, motor_adapter_nema23_44mm_countersunk.SLDDRW, motor_controller.SLDPRT, motor_mounting_plate.SLDDRW, motor_mounting_plate.sldprt, motor_tensioner_plate.SLDDRW]
2019-07-02 Change shaft spacers to closer fit tubing
    [Autotank.SLDASM, chassis.SLDASM, chassis_idler_pulley_spacer.SLDDRW, chassis_idler_pulley_spacer.SLDPRT, chassis_road_wheel_spacer.SLDDRW, chassis_road_wheel_spacer.SLDPRT]
2019-07-02 Add inner shaft spacer on idler pulleys
    [Autotank.SLDASM, track.SLDASM, track_drive_pulley.SLDPRT, track_idler_pulley.SLDPRT, track_idler_pulley_spacer.SLDDRW, track_idler_pulley_spacer.sldprt, track_road_wheel.SLDPRT]
2019-07-04 Add drawing for belt tensioner plate
    [belt_tensioner_plate.SLDDRW, belt_tensioner_plate.SLDPRT]
2019-07-26 Redesign drive and idler pulleys
    [Autotank.SLDASM, belt_tensioner.SLDASM, motor.SLDASM, track.SLDASM, track_drive_pulley.SLDPRT, track_drive_pulley.STL, track_drive_pulley_end_cap.SLDPRT, track_drive_pulley_end_cap.STL]
2019-07-26 Add drive pulley hardware, add pulley drawings
    [Autotank.SLDASM, chassis.SLDASM, chassis_idler_pulley_spacer.SLDDRW, chassis_idler_pulley_spacer.SLDPRT, chassis_road_wheel_spacer.SLDDRW, chassis_road_wheel_spacer.SLDPRT, track_drive_pulley.SLDDRW, track_drive_pulley_end_cap.SLDDRW]
2019-09-17 Add threaded inserts for drive pulley set screws, update tolerances
    [Autotank.SLDASM, track.SLDASM, track_drive_pulley.SLDPRT, track_drive_pulley.STL]
2019-09-19 Fix drive pulley set screw inserts, add relief for shaft collar screw
    [Autotank.SLDASM, track.SLDASM, track_drive_pulley.SLDPRT, track_drive_pulley.STL]
2020-02-22 Clean up files
    [Autotank.SLDASM, autotank.SLDASM, battery.SLDASM, battery_18650_14S1P.SLDASM, battery_18650_1S7P.SLDASM, battery_bracket.STL, battery_bracket.sldprt, battery_bus_bar.SLDDRW]
2020-02-22 Add missing drawings, update existing drawings
    [autotank.SLDASM, belt_tensioner.SLDASM, belt_tensioner_plate.SLDPRT, chassis.SLDASM, chassis_bottom_plate.sldprt, chassis_idler_pulley_spacer.SLDPRT, chassis_road_wheel_axle.SLDPRT, chassis_road_wheel_spacer.SLDPRT]
2020-02-22 Add VESC configuration
    [VESC Config.txt]
2020-02-22 Add bill of materials
    [BOM.csv, BOM.xlsx]
